KyellGomes/legocar/Roboterauto/README.md

Roboterauto
====
**Details zum Fahrgestell**

- Länge: 29 cm
 
- Breite: 16,5 cm

- Höhe: 22 cm 

- Gewicht: 1328 Gramm 

Wir haben TOF (Time-Of-Flight) Abstandssensoren getestet weil sie sehr schnell sind. Wir haben festgestellt dass diese Sensoren bei zu hellem Licht viele Fehler machen. Deshalb haben wir für den Notfall, also wenn das Licht vor Ort zu Hell ist, Ultraschallsensoren mit einem Schnellverschluss an den Kameraturm befestigt, sodass wenn das Licht dann vor Ort zu hell ist, wir dann schnell auf die Ultraschallsensoren umschwenken können. Außerdem haben wir ein Ausweichprogramm genau für dieses Lichtproblem damit wir es vor Ort nicht mehr programmieren müssen. 
Wir haben eine Bilderbauanleitung für die einzelnen Baugruppen des Autos verfasst. Zu finden ist das ganze unter Roboterauto/bauanleitung.
Wir haben uns entschlossen doch langsamer zu fahren und die Ultraschallsensoren zu benutzten weil dadurch insgesamt weniger Fahrfehler passieren.
