KyellGomes/legocar/Technische Zeichnungen/Zeichnung_Deckplatte.pdf

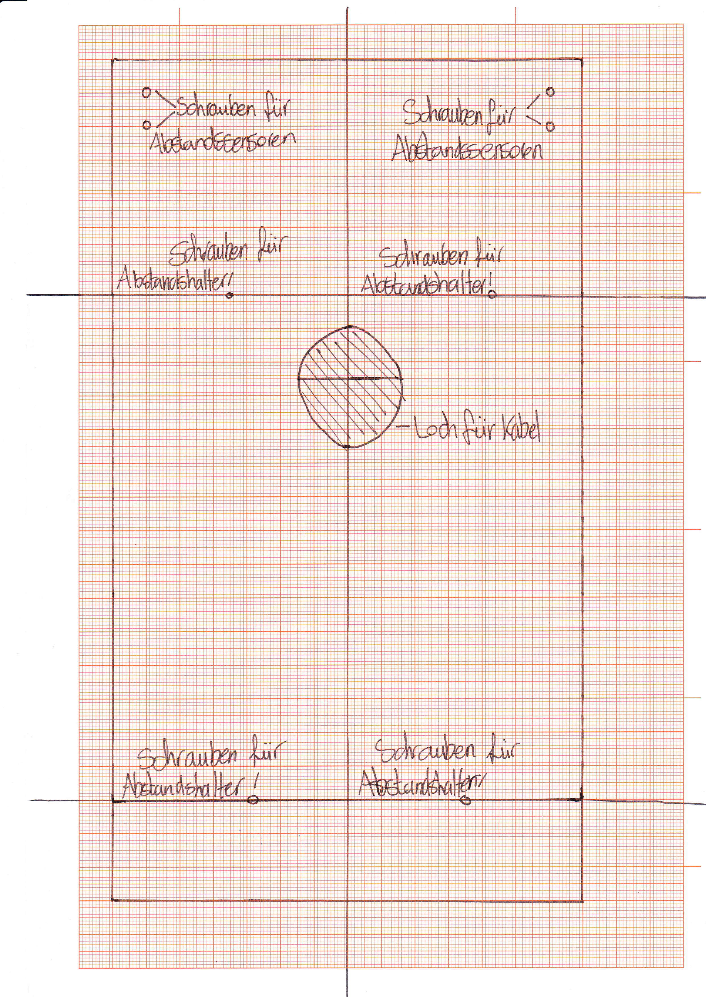
[picture p2: page 1]
