KyellGomes/legocar/Technische Zeichnungen/Zeichnung_Bodenplatte.pdf

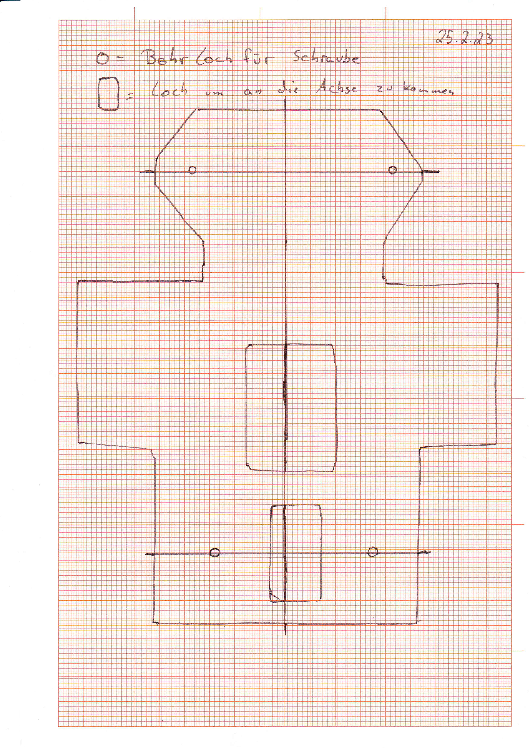
[picture p3: page 1]
