KyellGomes/legocar/Roboterauto/hintere Seite 1.JPG

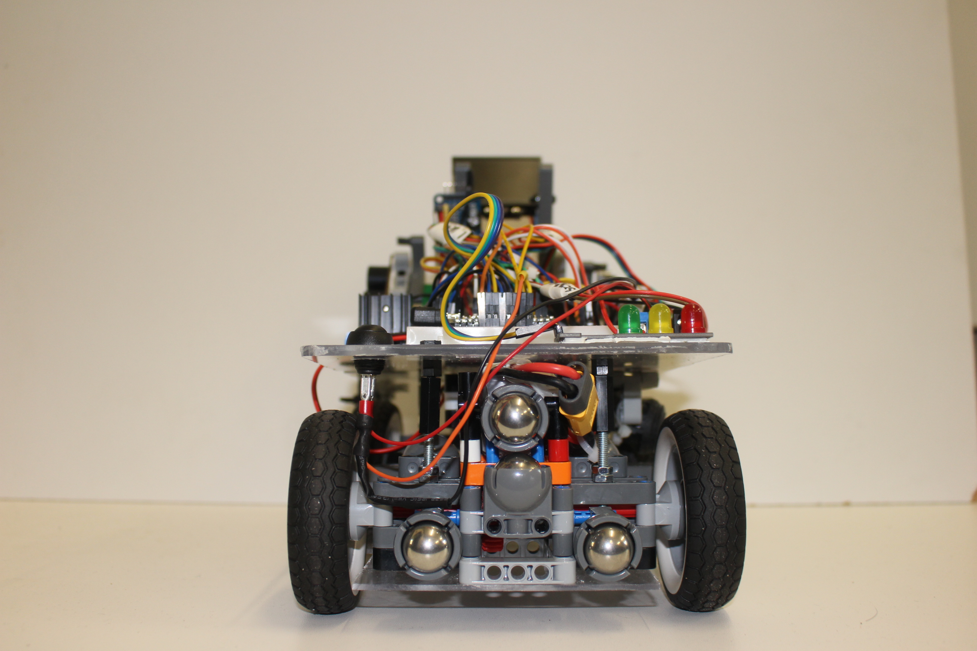
Roboterauto/hintere Seite 1.JPG
