KyellGomes/legocar/Roboterauto/linke Seite 3.JPG

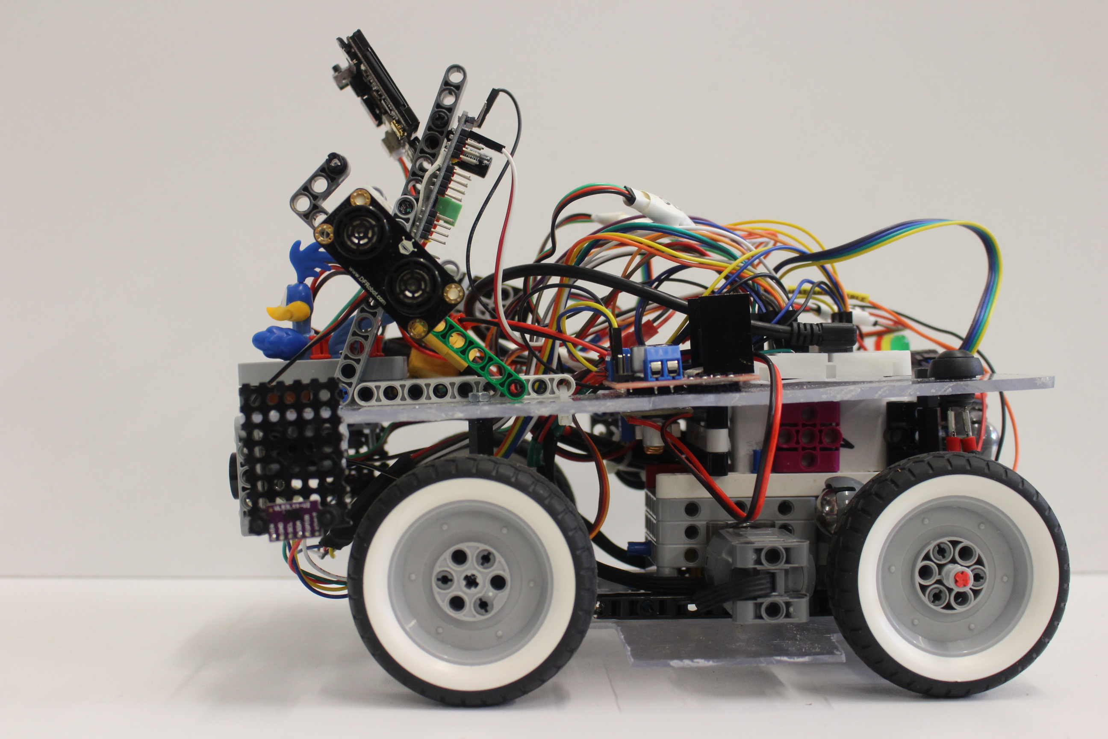
Roboterauto/linke Seite 3.JPG
