KyellGomes/legocar/Roboterauto/oben 1.JPG

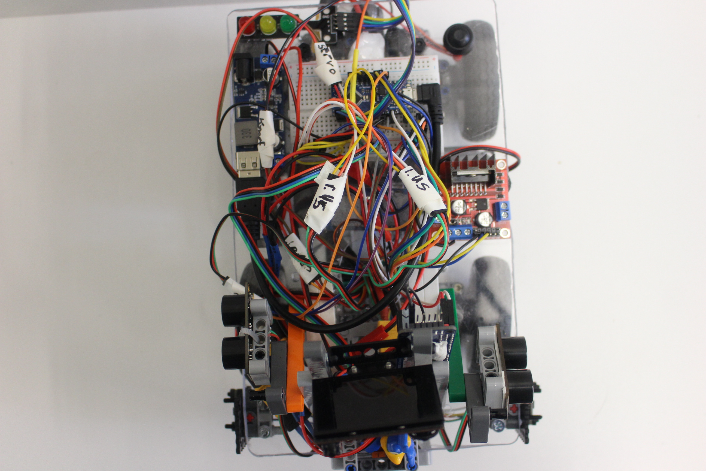
Roboterauto/oben 1.JPG
