KyellGomes/legocar/Roboterauto/rechte Seite 4.JPG

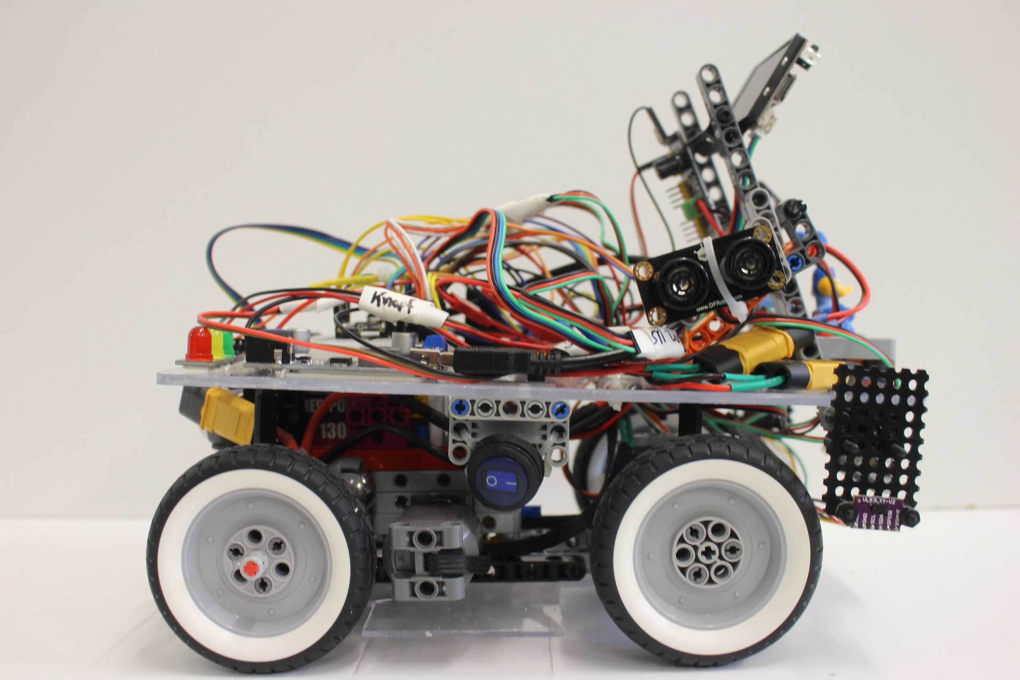
Roboterauto/rechte Seite 4.JPG
