KyellGomes/legocar/Roboterauto/unten.JPG

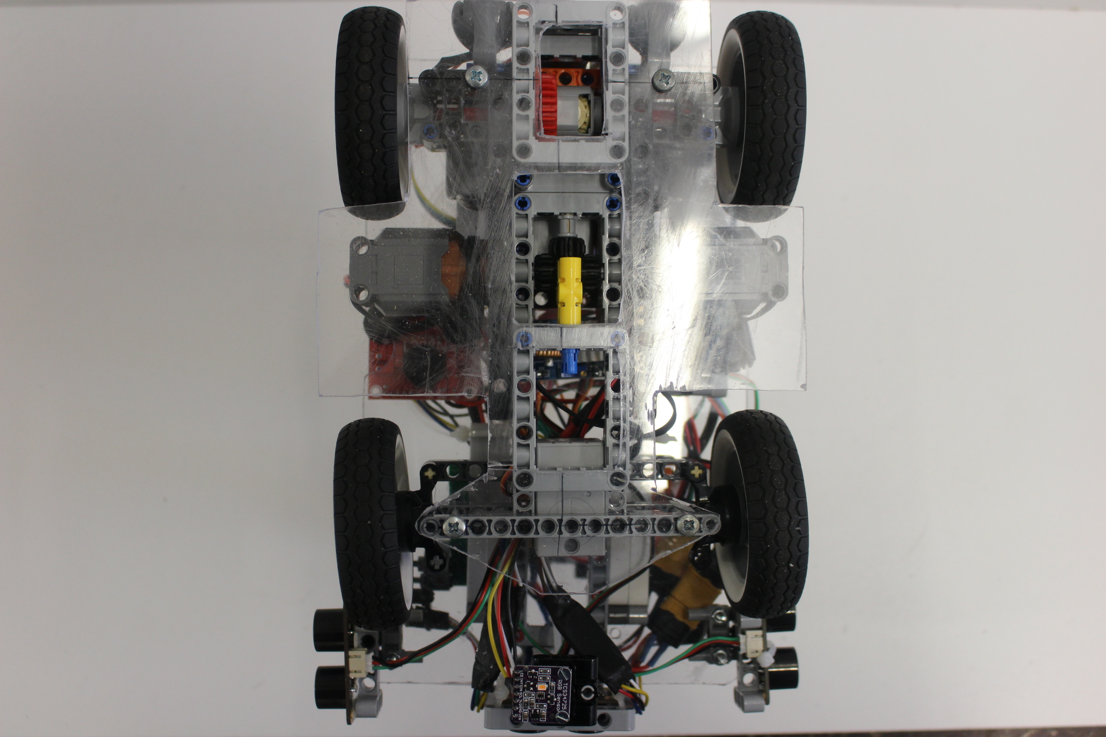
Roboterauto/unten.JPG
