KyellGomes/legocar/Roboterauto/vorne .JPG

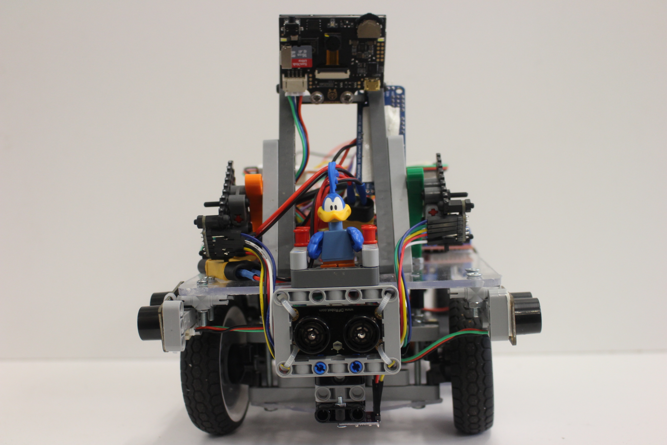
Roboterauto/vorne .JPG
