KyellGomes/legocar/Technische Zeichnungen/Schaltplan Roadrunners12_Schaltplan.pdf

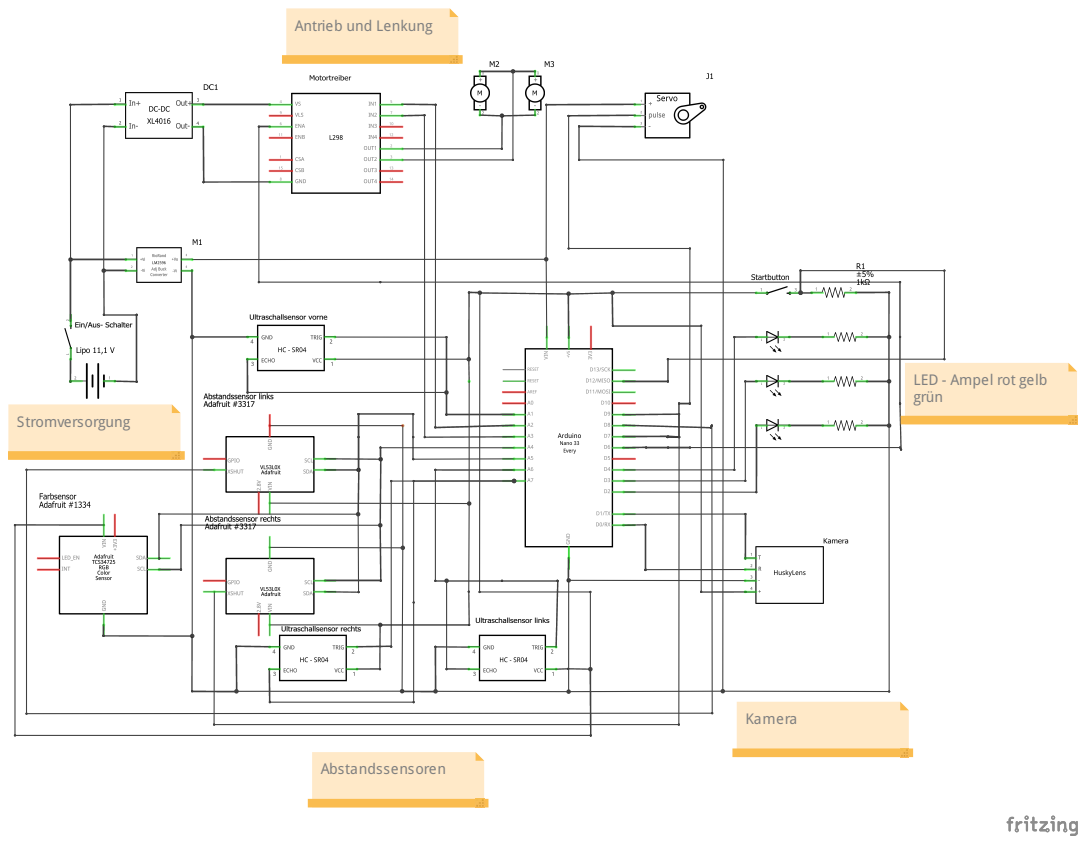
[picture p10: page 1]
Abstandssensoren; Stromversorgung; Kamera

Antrieb und Lenkung

LED - Ampel rot gelb
grün
