KyellGomes/legocar/Roboterauto/Foto_Bauanleitung.pdf

### Foto-Bauanleitung:

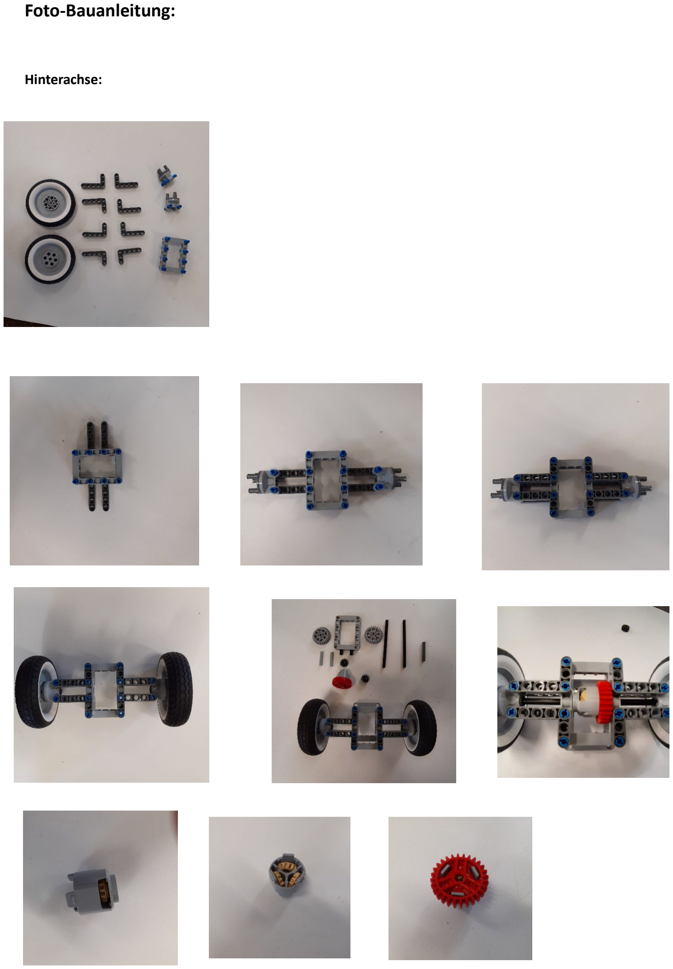
[picture p11: page 1]

Hinterachse:

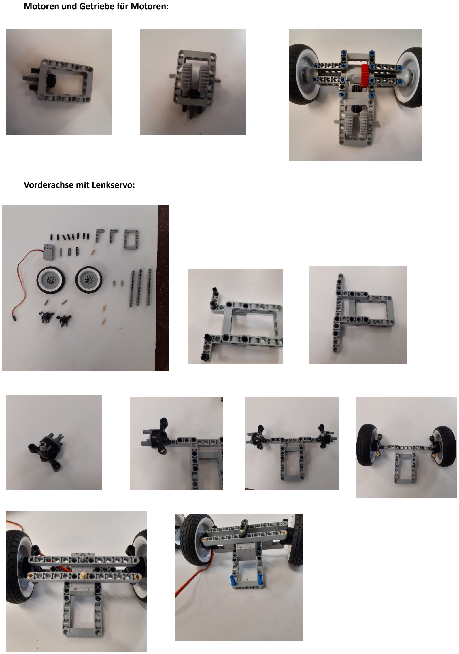
[picture p12: page 2]

Motoren und Getriebe für Motoren:

Vorderachse mit Lenkservo:

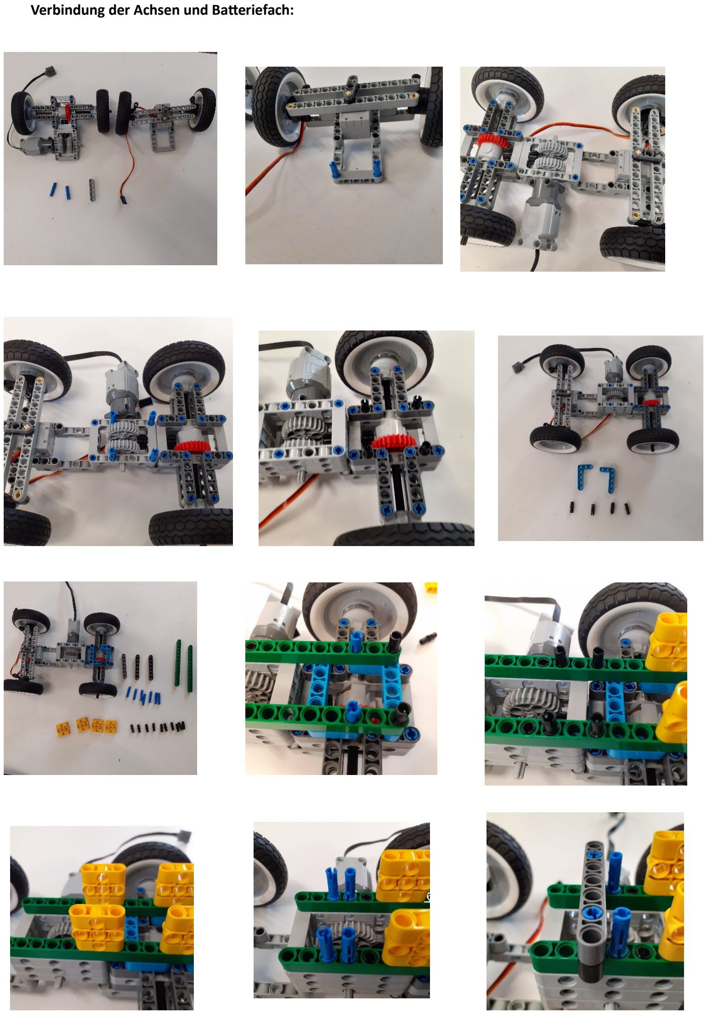
[picture p13: page 3]

Verbindung der Achsen und Bateriefach:

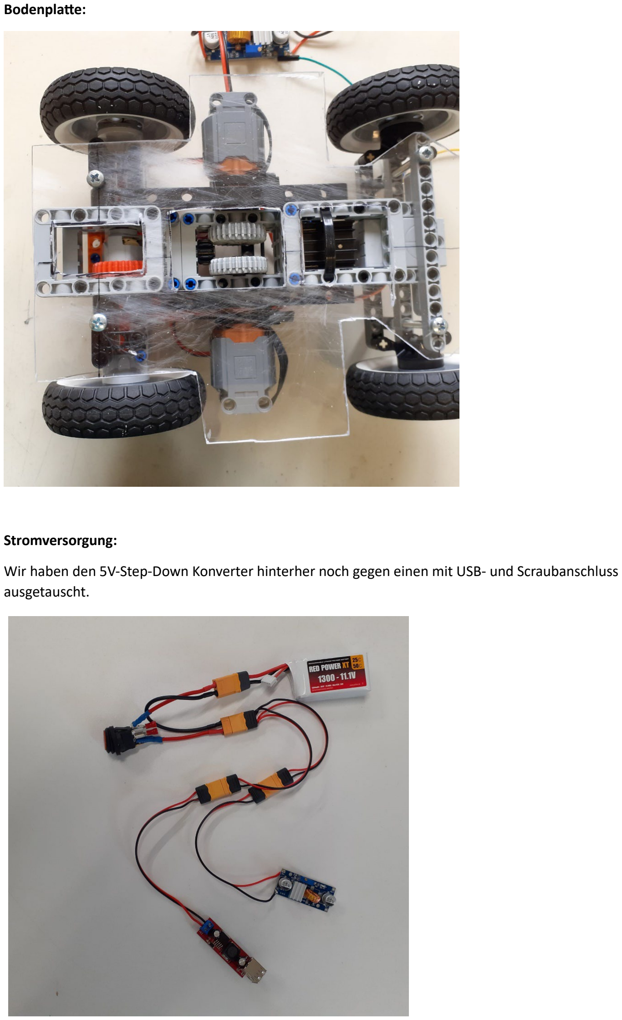
[picture p14: page 4]

Bodenplate:

Stromversorgung:
Wir haben den 5V-Step-Down Konverter hinterher noch gegen einen mit USB- und Scraubanschluss ausgetauscht.

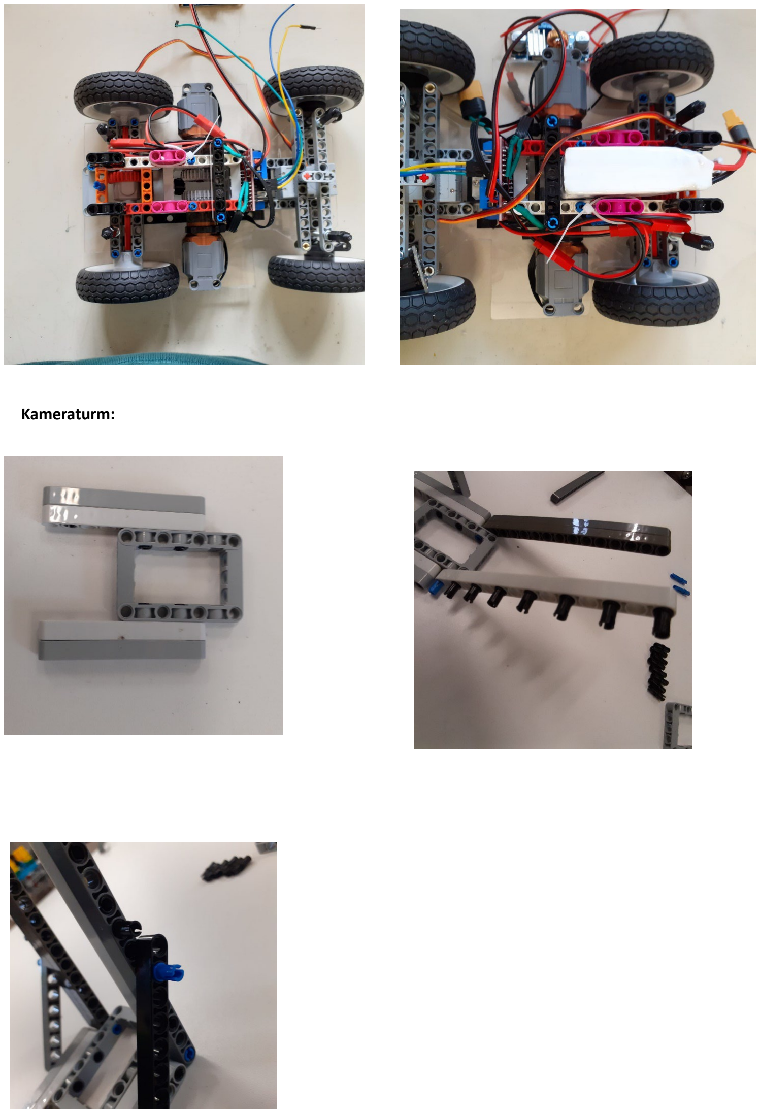
[picture p15: page 5]

Kameraturm:
