KyellGomes/legocar/(commit log)

2023-04-29 Update README.md
    Sensoren Beschreibung
2023-04-29 Add files via upload
    Neuer Schaltplan mit LED - Ampel und Beschriftungen
2023-04-30 Add files via upload
    neue Bilder wegen umbauten von Hinterachsengewichte und Motorgetriebe
2023-05-05 Add files via upload
    Pin von Motortreiber und Start - Button geändert
